nazmuremon/Pick-and-Place-CNC-converted/tests/data/slot3_real_parts.png

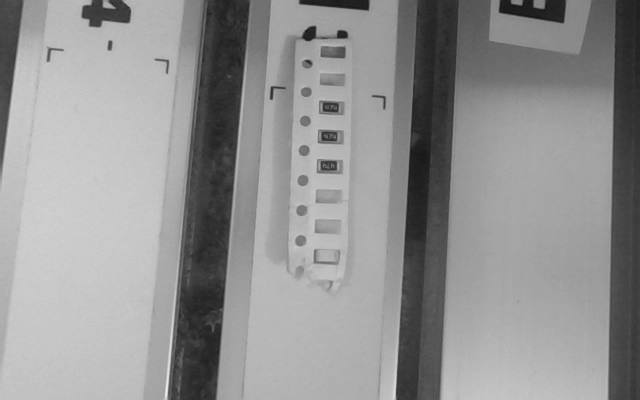
tests/data/slot3_real_parts.png
