nazmuremon/Pick-and-Place-CNC-converted/tests/data/bars_only.png

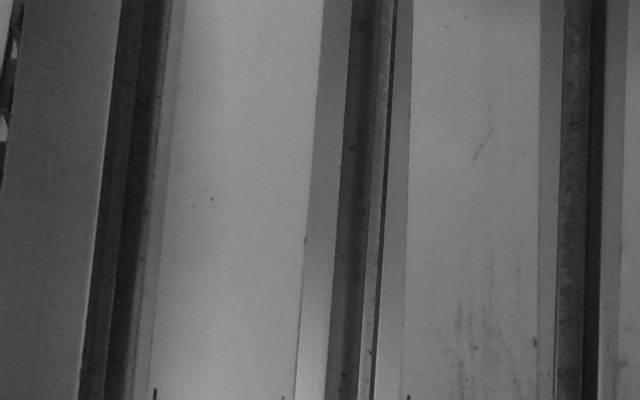
tests/data/bars_only.png
