nazmuremon/Pick-and-Place-CNC-converted/docs/02-architecture.md

# 02 – Architecture

## System diagram

```
┌───────────────────────── Raspberry Pi 5 (8 GB) ─────────────────────────┐
│ Python app                                                               │
│  job planner · vision (OpenCV) · calibration · safety checks · web UI    │
└────┬──────────────────────────────────────────┬────────────────┬─────────┘
     │ USB serial                               │ USB            │ CSI
     │ (G-code, also the nozzle servo, D18)     │                │
┌────▼───────────┐                            Top camera       Bottom camera
│ Pico + grblHAL │                            + LED ring       + LED ring
│ 3 axes + I/O   │                            (on the head,    (fixed,
└─┬────┬────┬──┬─┘                             looks down)      looks up)
  │    │    │  │ Outputs: grblHAL runs them only after the queued moves (D3, D18)
  │    │    │  ├─ Spindle PWM, 50 Hz ← M3 S<us> / M5 ──▶ MG995 servo = nozzle rotation (own 5–6 V supply)
  │    │    │  ├─ Flood coolant      ← M8 / M9 ──▶ MOSFET ──▶ vacuum pump
  │    │    │  └─ Mist coolant       ← M7 / M9 ──▶ MOSFET ──▶ solenoid valve   (MOSFETs + flyback diodes)
  │ STEP/DIR/EN through a 5 V buffer (74HCT245 / 74ACT245)
  ▼    ▼    ▼
 X drv Y drv Z drv
  │    │    │
  X    Y    Z
Inputs to Pico: E-stop (NC contact), driver ALARM outputs, 3 spare inputs for limit switches later
```
There is no second controller: the servo pulses come from the motion controller itself (D18).
On the bench Uno this runs now, with our Grbl build ([../firmware/README.md](../firmware/README.md)).
On the Pico with grblHAL the same mapping is planned: to be checked when there is a Pico (the owner has none now).

## Who does what

| Part | Job | Does NOT do |
|---|---|---|
| Raspberry Pi 5 | Plans the job, runs vision, calibration and the UI, checks soft limits, sends G-code, logs | Step pulses, anything that needs exact timing |
| Pico + grblHAL | Step pulses, acceleration, moving the axes together (X, Y, Z), pump and valve timing, the nozzle servo pulses (spindle PWM, D18), E-stop input | Vision, job logic, angle → pulse width (the app does it from the calibration table) |
| Stepper drivers | Drive the motors (closed-loop drivers also correct small errors and report ALARM) | — |
| Top camera | HOME mark, bed survey (all labels), feed-tray scan, board holes or fiducials, checking picks | Reading part values (it can only measure size) |
| Bottom camera | Part offset and angle on the nozzle (phase 7), finding the nozzle tip | — |

## Data flow for one job

```
bed.yaml (labels) ──▶ bed survey (top camera) ──▶ slot zones in machine mm, PCB area from bed.yaml
                                                   (used by the scan, the placement checks and safety)

KiCad board ──pcbnew──▶ placement list (ref, value, footprint, x, y, rot, side)
                               │
feeder.yaml ───────────────────┤──▶ job planner ──▶ loads of ≤ 5 lines (which line goes in which slot)
                               │                      │
                               │              operator lays a tape strip in each slot (load sheet / QR scan)
                               ▼                      ▼
                     board registration        feed-tray scan (top camera)
                     (holes/fiducials)          → part positions + angles along each strip
                               │                      │
                               └──────▶ pick/place loop ◀──────┘
                                          │  G-code (the nozzle angle too: M3 S<us>, D18)
                                          ▼
                                    Pico + grblHAL ──▶ motors, pump, valve, MG995 servo
```
The bed survey runs once after the labels are stuck, and again if a label moves.

## Interfaces

| Interface | Type | Notes |
|---|---|---|
| Pi ↔ Pico | USB CDC serial, grblHAL protocol | Send a line, wait for `ok`. Poll `?` for status (`Idle`, `Run`, `Alarm`). The nozzle angle is G-code too: `M3 S<us>` (D18) |
| Pi ↔ top camera | USB (UVC), OpenCV `VideoCapture` (V4L2) | Lock exposure, gain, white balance and focus with `v4l2-ctl` |
| Pi ↔ bottom camera | CSI, `picamera2` | Lock `AfMode=Manual`, `LensPosition`, exposure and gain |
| Pi ↔ operator | HTTP (FastAPI) + browser | Live camera with overlay, jog, calibration wizard, run/pause/skip |
| PC ↔ normal printer (laser preferred) | `tools/make_labels.py` → A4 PDF, printed at 100 % ("Actual size") on matte sticker paper | Bed labels: HOME, PCB corners (not used since D17), feed slots, and two 100 mm check bars (D12, D13). `hardware/print/bed_labels_a4.pdf`, preview `bed_labels_a4_preview.png`, and `bed_map.png` (where to stick each label) |
| Pi ↔ label printer (Brother PT-D410) | Existing `../solder_helper/label_server.py` | Part labels for a load (optional) |
| PC ↔ label printer (Brother PT-D410, 18 mm tape) | `tools/make_labels.py --tape --print --strip` → `ptouch-print` | The same bed labels on tape, one strip with cut marks (D15). First the 100 mm check label: `--tape --print --only scale_100mm` |
| PC ↔ test bench (Arduino Uno + our Grbl 1.1h servo build on the CNC, Xitech camera on the head) | USB serial, `tools/bench.py` + `config/bench.yaml` | Bench only, until the Pico is wired. `axis_map` fixes the motors that are on other drivers; caps for feed, step size and the measured reach (D17). Bench tools move only through `bench.Grbl`. Nozzle servo and pump relay: `tools/servo_pump_test.py`, `config/bench.yaml` `nozzle_servo` and `pump`; the firmware is in [../firmware/README.md](../firmware/README.md) (D18) |

## Decision log

Status: **Accepted** = we build it this way. **Proposed** = check it before building.
**Replaced by Dn** = not used any more; the row stays for the history.
**Changed by Dn** = still valid, except the part that Dn changes.

| # | Date | Decision | Why | What follows from it | Status |
|---|---|---|---|---|---|
| D1 | 2026-09-29 | The Pi doesn't generate step pulses. A Pico running grblHAL does motion | Linux isn't real-time (steps would be uneven), and `pigpio` doesn't work on the Pi 5. grblHAL has acceleration planning and supports the RP2040 | One extra board (~$5). Motion is plain G-code, and OpenPnP can use it too | Accepted |
| D2 | 2026-09-29 | Add a 4th axis A (TMC2209 + NEMA 8/11 hollow-shaft stepper) | Only 3 drivers exist. Without rotation, parts can only be placed at the angle they sit in the feeder | grblHAL must be built with 4 axes | Replaced by D18 (2026-10-07) |
| D3 | 2026-09-29 | Pump on the spindle output (M3/M5), valve on flood coolant (M8/M9) | In grblHAL these commands wait for queued moves to finish, so the valve opens only after Z arrives. Pi GPIO would not be in sync | A 3/2-way valve must be bought | Accepted. **Output mapping changed by D18 (2026-10-07):** pump on flood coolant (`M8`/`M9`), valve on mist coolant (`M7`/`M9`); the spindle PWM now drives the nozzle servo. The principle stays: synchronised Grbl outputs, never Pi GPIO |
| D4 | 2026-09-29 | Homing with the camera on a HOME mark + soft limits in the app | No limit switches (C4) | Home after every power-up and every E-stop. Re-check the HOME mark during jobs. `$22=0`, `$1=255` | Accepted; since D17 (2026-10-06) HOME sits just outside the camera reach, so homing measures it in the picture, and the soft limits come from the measured reach |
| D5 | 2026-09-29 | Top camera = USB, bottom camera = CSI | CSI ribbon cables break when they flex in a cable chain. The bottom camera doesn't move | The top camera needs locked UVC controls | Accepted |
| D6 | 2026-09-29 | Custom Python app instead of OpenPnP | The feeder idea (magazine, now the feed tray of D11) is custom, the scope is small, and Python + OpenCV runs natively on the Pi | More code to write. The hardware stays OpenPnP-compatible as a fallback | Accepted |
| D7 | 2026-09-29 | Magazine = swappable plates. Corner and plate-ID ArUco markers, lanes from plate geometry | Fewer markers to print and look after. Plate swaps are automatic. ~70 part lines don't fit on one plate | The job is split into loads. Lane labels are printed | Replaced by D11 (2026-10-06) |
| D8 | 2026-09-29 | Job input from KiCad via `pcbnew`. SMD = no through-hole pads | 28 SMD footprints on the target board aren't marked SMD, so a `.pos` export with "only SMD" misses them | Needs KiCad's Python (`pcbnew`) on the machine that makes the job file | Accepted |
| D9 | 2026-09-29 | Register the board on its 4 M3 mounting holes | The target board has no fiducials | Detect holes in vision. Add fiducials in board v2 | Accepted |
| D10 | 2026-09-29 | B-side rotation: θ_machine = 180° − θ_kicad (after mirroring X) | Mirroring maps angle θ to 180° − θ | **Must be checked by a dry run** before the first B-side job | Proposed |
| D11 | 2026-10-06 | Feeding = a hand-loaded **feed tray of 8 slots**. Each slot is one printed label on the bed: an ArUco marker (IDs 40–47 = slot 1–8), the slot number and a white 30 mm zone. One value + footprint line per slot; the parts lie loose in the zone or in a short cut-tape strip (cover tape off). Replaces D7 | Owner's choice: at most 8 components at a time, no automatic magazine, nothing to build. The zone is fixed relative to the marker, so a label can sit at any angle. The camera finds every part in the zone | Magazine plates, lanes, pins, magnets and markers 0–3 / 10–19 are retired. A job is split into **loads of ≤ 8 lines**, so more loads and refills (HT5023 B side: about 7 loads); the planner groups lines by nozzle across loads. The camera can't read values, so the app's load sheet says which line goes in which slot. Loose parts lie at any angle: polarity rules over 360°; touching or upside-down parts are unclear (never guess, R5). `feeder.py`, `config/feeder.yaml` | Accepted; slot content and size changed by D14 (2026-10-06): one cut-tape strip per slot, 60 × 16 mm tape mark, slots 30 mm apart. Loose parts are still possible, but not the normal way. Number of slots changed by D17 (2026-10-06): 5 slots (labels 3–7), loads of ≤ 5 lines |
| D12 | 2026-10-06 | All bed markers are labels printed on the **Brother PT-D410** (180 dpi, TZe 12 or 18 mm tape; 18 mm recommended) with `tools/make_labels.py`: HOME (ID 49), PCB area corners 1–4 (IDs 30–33), feed slots 1–8 (IDs 40–47), and a 50 mm scale-check label | The owner has the printer (solder_helper uses it). Labels are quick to print and stick, and they don't need exact placement: the camera measures every label (bed survey) | Marker size depends on the tape: 11.85 mm (18 mm tape), 8.47 mm (12 mm tape); the app reads it from `config/bed.yaml`. The PCB area (max 150 × 150 mm) is 10 mm inside the 4 corner marker centres, and the app refuses placements outside it. Glossy tape can cause glare. The ChArUco board still needs a laser printer (too big for tape) | Accepted; print medium changed by D13 (2026-10-06): A4 sticker paper, not the PT-D410. Labels, IDs and the bed survey stay. PCB area changed by D17 (2026-10-06): no PCB corner labels (out of reach); the PCB area is the board itself (130 × 140 mm, `config/bed.yaml`), and the board is found by its holes (D9) |
| D13 | 2026-10-06 | The bed labels of D12 are printed on **one A4 sheet of matte sticker paper** with a normal printer (laser preferred) at **100 % / "Actual size"** (no "fit to page"). `tools/make_labels.py` writes `hardware/print/bed_labels_a4.pdf` (vector, exact size), a picture of the page (`bed_labels_a4_preview.png`) and `bed_map.png` (where to stick each label). Changes only the printer of D12 | Owner's choice. A normal printer at 100 % gives exact marker sizes, the labels can be any size, and no special tape is needed | Every bed marker is **10 mm** with a ≥ 2.5 mm white border; the app reads the size from `config/bed.yaml` (`markers.size_mm`). Slot label 57 × 24 mm with a 30 × 20 mm zone; the slot centre lines move to a 28 mm pitch (Y = 20 … 216, `config/bed.yaml`). The sheet has two **100 mm check bars** (one across, one down): both must measure 100.0 mm (±0.5 mm), or the printer scaled the page: print again at 100 %. Cut the labels out along the thin grey lines. Matte paper, not glossy (glossy reflects the LED ring). No `ptouch-print`, no tape, no 50 mm scale-check label. The labels, IDs and bed survey of D12 stay the same | Accepted; slot label size and slot pitch changed by D14 (2026-10-06); printing on 18 mm tape added by D15; slot positions changed by D16, then by D17 |
| D14 | 2026-10-06 | Slots hold **cut-tape strips side by side, 30 mm centre to centre**. The operator peels the cover film off by hand and lays one strip in the slot's **tape mark**: sprocket **holes to the back** (away from the operator), the **row of parts on the centre marks** (a short black mark just outside each end of the tape mark, on its centre line). Slot label **87 × 20 mm** with a **60 × 16 mm tape mark** (it still starts 17 mm from the marker centre). Changes the slot content of D11 and the slot size and pitch of D13 | Owner's choice. Tape keeps the parts upright and in a known orientation. One strip holds a whole line: 60 mm holds about 15 parts at 4 mm pitch, and the largest HT5023 line needs 13 (11 + 2 spares) | 8 slots at 30 mm (centre lines Y = 11 … 221) fill the 232 mm bed width: slot 1 and slot 8 are only **1 mm** from the front and back edges, so the travel must reach almost the whole bed width (Q1). HOME moved to (220, 14), in front of the PCB area; the bottom camera (phase 7) to about (115, 116). The 16 mm mark fits 8 and 12 mm tape only: **12 mm tape is the maximum** (16 mm tape, phase-7 parts, does not fit). `tape_mm`, `pitch_mm` and `angle_in_tape` in `config/feeder.yaml` are useful again: the camera predicts the next pocket from the pitch, and still checks the polarity of every part (cross-check with `angle_in_tape`, measured on the first strip). A camera view (about 60 × 34 mm) no longer covers a whole slot (marker to end of the mark ≈ 82 × 16 mm): **2 camera views per slot**. Loose parts are still possible, but not the normal way | Accepted; layout changed by D16 (2026-10-06): the bed is 240 × 440 mm, so the slots no longer fill the bed width and slot 1 / slot 8 are not at the bed edges any more. Changed by D17 (2026-10-06): 5 slots on the T-slot bars, running front-back (not 8 across the bed); the holes go to the side the top of the slot number points to, which is the RIGHT on this bed. Slot content, label and tape mark stay |
| D15 | 2026-10-06 | The bed labels can also be printed on the **Brother PT-D410 with 18 mm tape**: `tools/make_labels.py --tape --print --strip` prints the same labels at 180 dpi as **one strip with cut marks**; the operator cuts them apart by hand. Print the **100 mm check label** first (`--tape --print --only scale_100mm`) and measure it. The owner printed the full set this way on 2026-10-06 (the check label measured 100 mm) | Owner's choice: the printer and 18 mm tape were at hand | Same labels, IDs, 10 mm markers and layout as D13/D14 (the markers measure 10.01 mm in `ptouch-print`'s own render). Tape labels are 18 mm high instead of 20 mm, so slot 1 and slot 8 are 2 mm from the bed edges. One strip, not one job per label: every job wastes blank tape at both ends. 12 mm tape is too narrow (10 mm marker + white border). The A4 sheet (D13) stays a valid way to print them | Accepted; layout changed by D16 (2026-10-06): the labels stay the same, but slot 1 and slot 8 are no longer at the bed edges (slot 1's tape label is 6 mm from the front edge). Layout changed again by D17 |
| D16 | 2026-10-06 | The bed is **240 × 440 mm** (X × Y: 240 mm left-right, 440 mm front-back), not 320 × 232. New layout: **slots 1–8 at the front-left**, HOME and the bottom camera beside them, the **PCB area at the back**. The labels stay the same | The owner measured the bed again. The first numbers (320 × 232 mm, with 320 along X) were wrong | The old layout (slots on the left of a 320 mm X, PCB area on the right) is replaced. New positions (`config/bed.yaml` → `layout`, drawn in `hardware/print/bed_map.png`): slot labels with the left end at X = 10 and centre lines Y = 15, 45 … 225 (still 30 mm apart, slot 1 at the front, D14); HOME (150, 20), front right, beside slot 1; bottom camera (phase 7) about (150, 150); PCB area (45, 260) to (195, 410), corner markers (35, 250), (205, 250), (205, 420), (35, 420). Slot 1 and slot 8 are no longer at the bed edges: slot 1's front edge is 5 mm (A4 label) or 6 mm (18 mm tape label) from the front edge. Free space right of the slots (about X 100–240, Y 0–235), for example for the nozzle rest. The travel needed is mostly in Y: about 190–225 mm in X and 405–440 mm in Y (estimate, final after Q1 and the measured camera-to-nozzle offset). The printed labels (D15) don't change, only where they go | Accepted for the bed size. The layout is replaced by D17 (2026-10-06): the machine reaches only about 150 × 230 mm |
| D17 | 2026-10-06 | **Layout that fits the measured reach.** Positions in **mm from the centre of the HOME marker**, +X right, +Y back (`config/bed.yaml` → `layout`, drawn in `hardware/print/bed_map.png`). **5 slots** (printed labels 3–7, ArUco 42–46) on the T-slot bars of the bed, running front-back: marker at the BACK end, tape mark towards the front, tape holes to the RIGHT (the side the top of the slot number points to), parts on the centre marks. **HOME** (ID 49, text cut off: a 15 mm square label) on the next bar right of slot 3 (the old slot-2 bar), in line with the slot markers. **PCB area = the HT5023 board, 130 × 140 mm**, front-left corner at (−144, −224), just in front of the slot labels. **No PCB corner labels.** Bottom camera _TBD_. Replaces the layout of D16 (and the owner's 7-slot layout of the same day) | First bed test run on the bench (`tools/bed_test_run.py`): with no limit switches, the head hit the right end once (slow, no damage). Then the owner jogged to every end (stopping ~5 mm before it): the camera centre reaches only about **150 × 230 mm** (X × Y) of the 240 × 440 mm bed (from the old HOME: X −94 … +56, Y −160 … +70). The D16 layout needed about 190–225 × 405–440 mm. Owner's choice of layout | Measured marker centres (automatic survey 2026-10-06, `logs/test_run/20261006-163410/survey.yaml`): slot 3 (−29.2, −1.5), slot 4 (−58.9, +0.8), slot 5 (−89.0, +2.7), slot 6 (−120.5, +2.5), slot 7 (−150.0, +1.7). The bars are 29.5–31.5 mm apart, not exactly 30. Labels 1, 2 and 8 are spares; PCB 1–4 are not used. Reach from the new HOME: about X −154 … −4, Y −227 … +3 (estimate, `config/bench.yaml` `limits.reach_from_home`; measure it with `--measure-reach`). The bench tools refuse every move outside it. HOME sits ~4 mm outside the camera-centre reach, so homing **measures** HOME in the picture (no move onto it) and sets the origin from that offset. PCB area X −144 … −14, Y −224 … −84: only ~3 mm to the front ends of the slot labels, so the PCB holder (step 6.3) must fit there. **Largest board on this machine: 130 × 140 mm** (R8). The board is found by its 4 holes (D9). **Loads of ≤ 5 lines**: HT5023 F side 2 loads, B side about 11 (check in step 6.2). **Risk (K9):** the nozzle reaches only the camera reach shifted by the camera-to-nozzle offset, so the head (step 2.1) must keep the nozzle very close to the camera. Q1 is still partly open | Accepted (the reach from the new HOME is an estimate until it is measured) |
| D18 | 2026-10-07 | **Nozzle rotation = an MG995 hobby servo**, not a 4th axis. Replaces D2 (4th axis A: TMC2209 + NEMA 8/11 hollow-shaft stepper). The servo signal comes from the **motion controller itself**: no second board, no extra USB cable (changed the same day: first a separate small controller on USB was proposed). Bench: our Grbl build (Grbl 1.1h + `firmware/grbl-1.1h-servo/grbl/servo_spindle.c`, `$I` = `VER:1.1h.20261007`, see [../firmware/README.md](../firmware/README.md)). The spindle pin **D11** (printed "Z+ / Z-" on the CNC shield V3, end-stop header: the signal pin, not the GND pin) sends the servo pulses: **`M3 S<us>` = pulse width in microseconds** (500–2500, 2 µs steps, one pulse every 20.48 ms). `M5`, `S0`, a reset or an alarm stop the pulses (servo limp). The outputs move (this changes D3's mapping, not its principle): **pump = flood coolant `M8`/`M9`** (CoolEn, A3, through the active-HIGH relay module on the bench), **valve (later) = mist coolant `M7`/`M9`** (A4; `ENABLE_M7` is on in our build). Real machine (Pico + grblHAL, D1): the same mapping is planned (grblHAL spindle PWM at 50 Hz for the servo, pump on flood, valve on mist): to be checked when there is a Pico (the owner has none now) | Owner's choice: everything on the one board he has (no Pico and no second Arduino). Grbl 1.1h has no 4th axis, but its spindle PWM pin can make servo pulses with a small firmware change. Like every spindle command, Grbl runs `M3 S<us>` only after the moves before it, so the turn is in sync with the G-code queue | **Axes are X, Y, Z only** (grblHAL with 3 axes). The nozzle angle is a servo angle, not a G-code axis. The app sets it **between moves** with `M3 S<us>`: after the pick lift (the servo turns during the travel), and the turn must be finished before Z goes down at the place. The servo has no feedback, so the app waits a settle time after each turn (`G4 P<settle>`; `servo.settle_s`, on the bench `nozzle_servo.settle_s`: _TBD_, not measured yet). Angle → pulse width comes from the calibration table (`config/machine.yaml`, _TBD_), measured with the camera. Range: the owner's MG995 is the **270° version** (the real range depends on the pulse range; measure it with the camera). Any turn from −180° to +180° fits, so the board rotations 0, 90, −90 and 180° are all possible, because the nozzle angle at the pick is free: the app picks at the servo angle that leaves room for the turn it needs. Power: its own 5–6 V supply (the MG995 runs on 4.8–7.2 V and draws over 1 A when it stalls; current rating _TBD_; for example a buck converter from the 12 V PSU), a large capacitor (about 1000 µF) at the servo plug, and a common GND with the controller. **Never from the controller's 5 V pin** (Uno or Pico): a voltage dip resets Grbl and the position is lost. No hollow shaft: the nozzle sits on the servo horn, centred on the output axis; the vacuum reaches it through a loop of soft silicone tube (twists up to the servo's 270°) or a small rotary union. Risks: a few tenths of a degree dead band, some jitter, and about 55 g more on the Z axis. Bench test: `tools/servo_pump_test.py`. Wiring: [../hardware/wiring/bench_pump_servo_wiring.html](../hardware/wiring/bench_pump_servo_wiring.html). Rollback: `firmware/grbl-1.1h-stock.hex` and the saved settings (see [../firmware/README.md](../firmware/README.md)) | Accepted (bench: flashed and tested 2026-10-07; Pico: to be checked) |
| D19 | 2026-10-07 | **Bench: Z0 = the remembered camera height, driven back to at every start.** Grbl's Z restarts at 0 in every session and Z slides down when the power is off. So `tools/nozzle_calibrate.py` keeps one reference (`config/nozzle_calibration.yaml` `z_reference`): the pick slot's label at the picture centre has a known size (px per mm) at Z0. At every start (`h`) it measures that size, works out how far Z is off (1 / size is linear in the height; the factor comes from a 1 mm move up), and **moves Z back**, coming down onto it. It goes up by itself up to `z_cal.max_drift_mm`, down only up to `z_cal.restore_max_down_mm`; more needs the owner. Every height (`k` pick, `d` place, `m` moving, `t` paper) and nozzle offset (`n`) is stored in mm from Z0, tagged with the reference, and used only after that check. Key `0` (twice) makes a new reference (everything is set again) | The head camera is tilted ~25°: its picture centre moves ~0.47 mm on the bed per mm of camera height. So correcting only the stored numbers (the first idea) is not enough: the camera itself must be at the same height, or the camera calibration, HOME and the nozzle offsets are off. HOME can't be centred (it is outside the reach), and a label away from the picture centre changes size with its position in the tilted picture, so the pick slot's label is brought to the centre | Every measuring picture and every X / Y move happen at Z0 or at the moving height. X / Y is refused with the nozzle low (`nozzle.move_clearance_mm` = docs/08's tallest part 2.5 mm + 2 mm; the owner's own jogs `nozzle.jog_clearance_mm`). A session that did not end cleanly (Z not back at Z0), or a Grbl reset, locks the machine: only lifting Z by hand, then `h`. The offsets are measured where they are used (pick: on a part, place: on a board hole). Real machine: a Z limit switch / probe will replace this (D4 keeps the inputs free) | Accepted (bench; simulated, not yet run on the machine) |
| D20 | 2026-10-08 | **The first operator app is the web page `ui/app.py` on the bench engine** (`ui/engine.py`, built on `tools/nozzle_calibrate.py`), not yet the planned `src/pnp/` modules | The owner asked for a full GUI with the live camera, manual calibration, feeder choice and automatic pick and place now. The bench engine has every safety lock and 170+ tests; rewriting it as `src/pnp/` first would delay it a lot | FastAPI + one page, as planned (this table, "Pi ↔ operator"). Later the engine parts move into `src/pnp/` (motion, vision, runner) without changing the page. Parts with a polarity or more than 2 pads stay hand-placed until the polarity check (docs/06) exists | Accepted |
