nazmuremon/Pick-and-Place-CNC-converted/hardware/tray/stl/smd_tray_slot2.stl

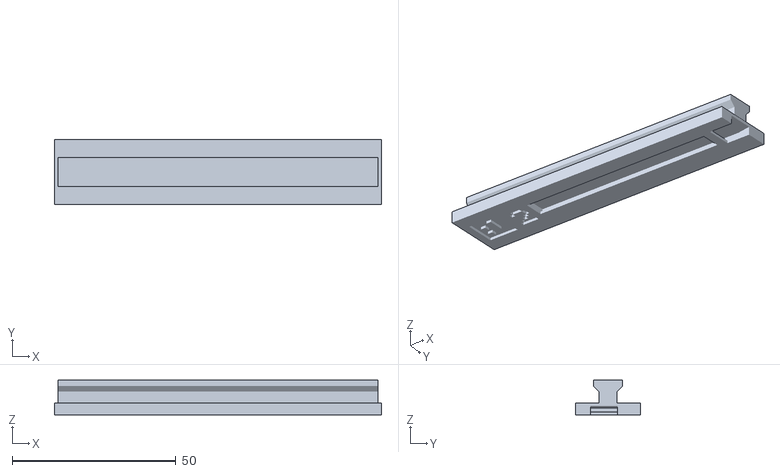
[picture p3: CAD file, 2026-10-12]
hardware/tray/stl/smd_tray_slot2.stl
100.0 x 20.0 x 10.6
