nazmuremon/Pick-and-Place-CNC-converted/(list of files, cad)

Other CAD files:
hardware/tray/stl/smd_tray_slot5.stl
hardware/tray/stl/smd_tray_slot3.stl
hardware/tray/stl/smd_tray_slot1.stl
hardware/tray/stl/smd_tray_slot6.stl
hardware/tray/stl/smd_tray_slot4.stl
