nazmuremon/Pick-and-Place-CNC-converted/hardware/wiring/bench_pump_servo_wiring.html

HT5023 pick and place · test bench · 2026-10-07

# Bench wiring: vacuum pump and nozzle servo

Everything runs from the one Arduino Uno with the Protoneer CNC Shield V3.00. The Uno runs our Grbl build ($I shows 1.1h.20261007). Its spindle pin D11 sends the servo pulses: M3 S1500 means a 1500 µs pulse. The pump relay sits on the coolant pin: M8 on, M9 off. Grbl runs both only after the moves before them have finished. One buck converter set to 5.0 V feeds the MG995 270° servo and the relay module, so nothing takes power from the Uno; its ground is joined to the shield's.

## On the board

1. 1Z+ row, signal pin (inner row) → servo orange. This is D11, the servo pulses: M3 S<µs>.
2. 2CoolEn row, signal pin (inner row) → relay IN. This is A3: M8 pump on, M9 off.
3. 3CoolEn row, GND pin (at the board edge) → the ground rail: relay GND, buck OUT−, servo brown.

The buck converter, set to 5.0 V, feeds the servo (red) and the relay module (VCC); the MG995 runs on 4.8–7.2 V. So nothing draws power from the Uno's 5 V. Find the rows by the names printed next to the header; in each row the pin at the board edge is GND (it beeps against the 12–36V minus on a meter). The relay's screw terminals may be in another order on your module (NO · COM · NC): go by the printed names.

## Schematic

- Pump supply + (voltage TBD)
- +5.0 V (servo and relay)
- Signal
- Ground
- USB

One board drives everything. The relay's contacts (COM, NO) carry only the pump current, and its coil side is switched from CoolEn. The servo and the relay take their 5.0 V from the buck converter, never from the Uno. Its supply ground, the buck's OUT−, is joined to the shield's GND, so the pulses from D11 have a reference.

## Shield pins

Printed on shield | Pin | Our Grbl build | Goes to
Z+ (or Z−) | D11 | Servo pulses: M3 S<µs> (500–2500), M5 stops them | Servo orange
CoolEn | A3 | Flood: M8 on, M9 off | Pump relay IN
SDA | A4 | Mist: M7 on, M9 off | Valve relay IN, later
GND | GND | Ground | Ground rail: relay GND, buck OUT−, servo brown (use the CoolEn row's edge pin)
SpnEn | D12 | Z limit input | Nothing
SpnDir | D13 | Spindle direction | Nothing

The shield's labels come from Grbl 0.9. In Grbl 1.1 the spindle output is D11, which the shield prints as the Z end stop. Each end-stop place has a signal pin and a GND pin. The GND pin beeps against the shield's GND on a meter, so use the other one. Check where A4 comes out on your shield with a meter too, before you add the valve.

## Before power-on

1. Relay first, USB only. Without the pump supply, run tools/servo_pump_test.py --pump: the relay must click on for 3 s, then off. If it works the other way round, the module is active-LOW: set its jumper to H, or use another module.
2. Set the buck converter to 5.0 V with a meter before the servo is plugged in.
3. Capacitor at the servo plug, stripe (−) to GND.
4. Join the grounds: buck OUT− to the shield's GND (the CoolEn row's pin at the board edge). Without it the servo twitches and the relay may not switch.
5. Diode across the pump, stripe to the pump's +.
6. Servo test: tools/servo_pump_test.py --servo sweeps it (centre, both ends, quarter points) and leaves it at the centre. --us 1500 holds one position, --off lets it go limp.

Never feed the servo from the Uno's 5 V pin. Its current peaks pull the 5 V down and reset the Uno, and then the head position is lost.

## Parts for this wiring

Part | What to get | Note
Relay module | 5 V coil, 1 channel, active-HIGH (or an H/L jumper) | Contacts rated above the pump current
Resistor | 10 kΩ | IN to GND: the relay stays off while the Uno resets
Diode | 1N5819 or 1N4007 | Across the pump, stripe to +
Fuse | TBD | A little above the pump's running current
Pump supply | TBD voltage | From the pump's label; the docs assume 12 V
Buck converter | 3 A or more; input range covers the pump supply | Output set to 5.0 V: feeds the servo and the relay module
Capacitor | 1000 µF, 10 V or more, electrolytic | Right at the servo plug
Servo | MG995, 270° version | Brown GND, red +, orange signal

## Still open

- Pump voltage and current, which set the supply and the fuse.
- Pulse width to nozzle angle, and the time the servo needs to turn. Until they are measured, the tools wait 1 s after each turn. The 270° range differs from servo to servo, so it is measured, not assumed.
- The valve on A4, when you add it: the same relay wiring as the pump, with its own diode across the valve coil.
