nazmuremon/Pick-and-Place-CNC-converted/hardware/print/bed_labels_a4.pdf

# Bed labels - pick and place robot

1. Print at 100 % (Actual size), NOT ’fit to page’. Matte sticker paper.
2. Measure both bars: each must be 100 mm (+-0.5). If not, the printer scaled the page.
3. Cut along the thin grey lines. Stick flat on the bed as in hardware/print/bed_map.png.
Tape: film off, strip in the slot mark, holes on the side the top of the number points to, parts on the centre marks.

ArUco DICT_4X4_50, 10 mm. HOME = 49, PCB 1-4 = 30-33, slots 1-5 = 42-46. Made by tools/make_labels.py

3

4

5

6

7

# HOME

100 mm

100 mm
