nazmuremon/Pick-and-Place-CNC-converted/hardware/print/smd_identify_sheet.pdf

This bar must be 50 mm. If not, print again at 100 % (Actual size, no ’fit to page’).

# SMD identify sheet

Put parts on the white area between the 4 markers, a few mm apart and away from the markers. Point the camera straight down. All 4 markers should be in view if possible.

Markers: ArUco DICT_4X4_50, IDs [20, 21, 22, 23], 10 mm. Area 70 x 45 mm. Made by tools/smd_identify.py.
