nazmuremon/Pick-and-Place-CNC-converted/hardware/print/bed_labels_a4_preview.png

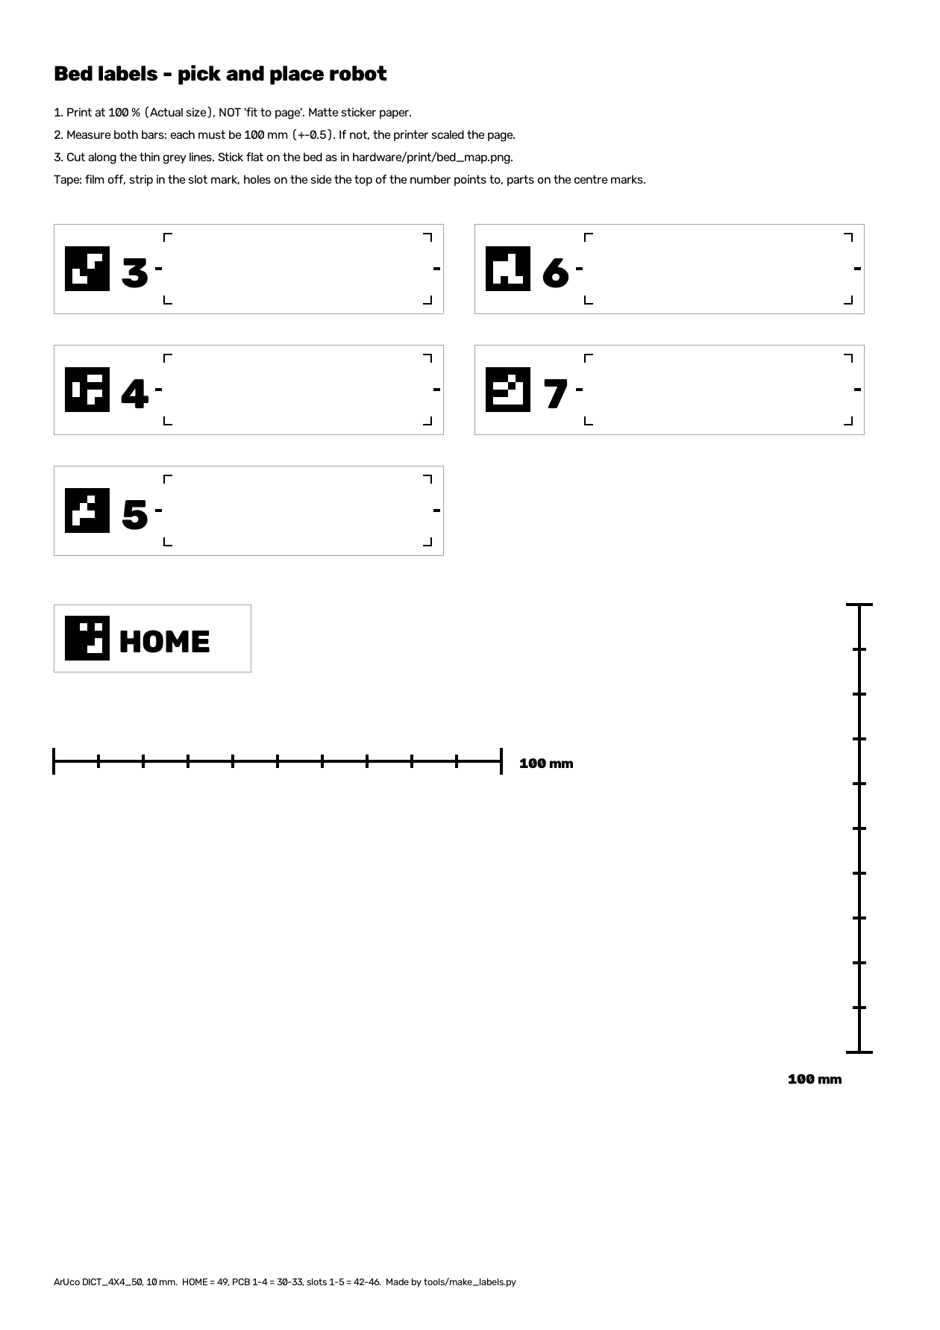
hardware/print/bed_labels_a4_preview.png
