nazmuremon/Pick-and-Place-CNC-converted/hardware/print/bed_map.png

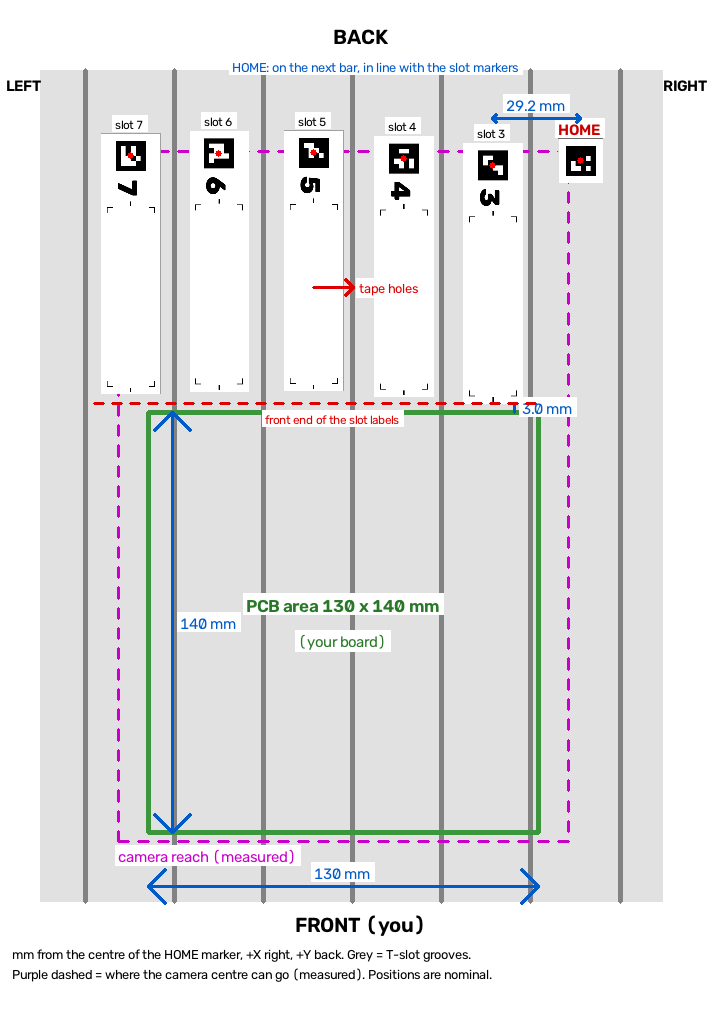
hardware/print/bed_map.png
