nazmuremon/Pick-and-Place-CNC-converted/hardware/print/tape/home.png

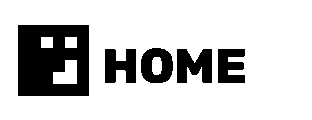
hardware/print/tape/home.png
