nazmuremon/Pick-and-Place-CNC-converted/hardware/print/tape/pcb_1.png

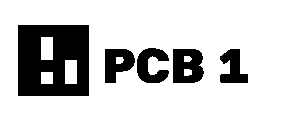
hardware/print/tape/pcb_1.png
