nazmuremon/Pick-and-Place-CNC-converted/hardware/print/tape/pcb_2.png

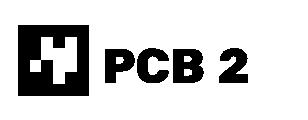
hardware/print/tape/pcb_2.png
