nazmuremon/Pick-and-Place-CNC-converted/hardware/print/tape/preview.png

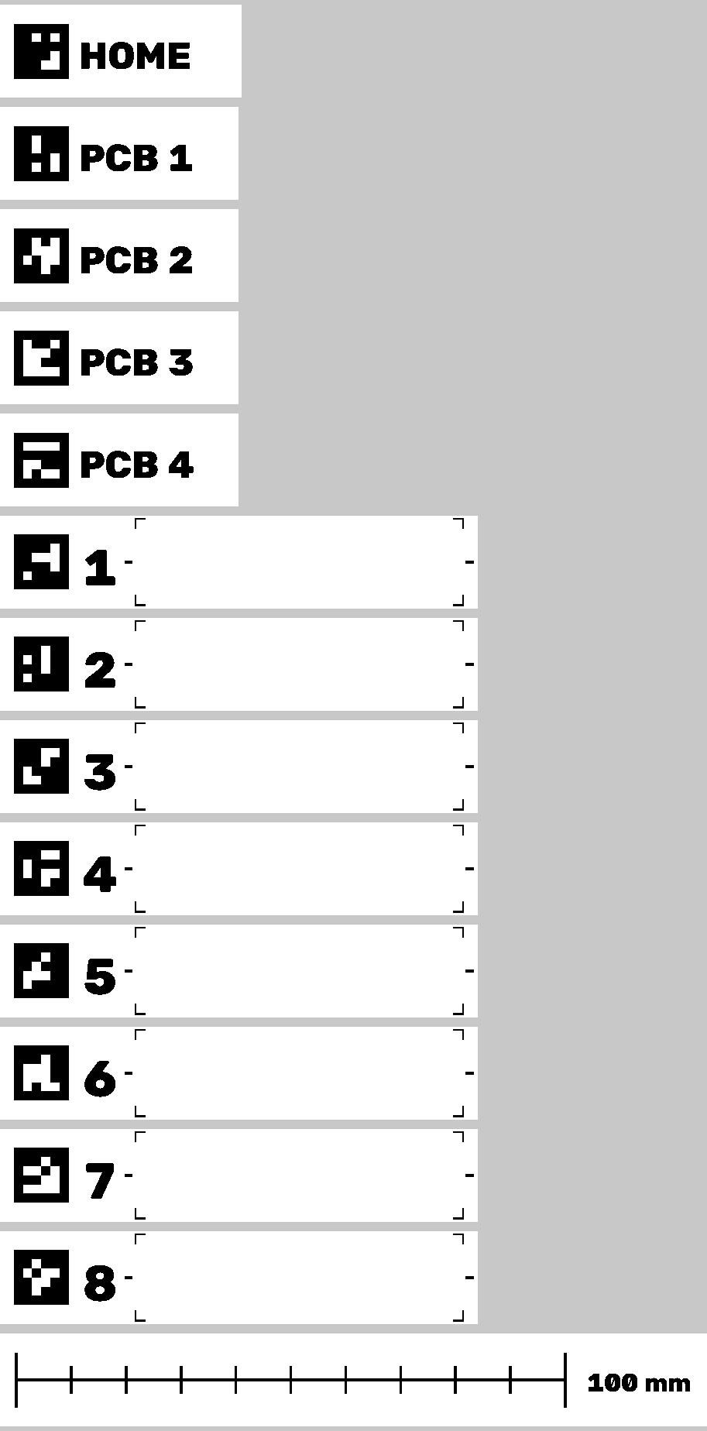
hardware/print/tape/preview.png
