nazmuremon/Pick-and-Place-CNC-converted/(notices)

Notices in the files:
firmware/grbl-1.1h-servo/grbl/config.h:
Copyright (c) 2012-2016 Sungeun K. Jeon for Gnea Research LLC
Copyright (c) 2009-2011 Simen Svale Skogsrud
Grbl is free software: you can redistribute it and/or modify
it under the terms of the GNU General Public License as published by
the Free Software Foundation, either version 3 of the License, or
(at your option) any later version.
